Jp-K/smartrope-esp32-v2/LiTE INO 2.2 rev. 01 (GND Plan)/LiTE INO 2.2 rev. 01 (GND Plan).JPG

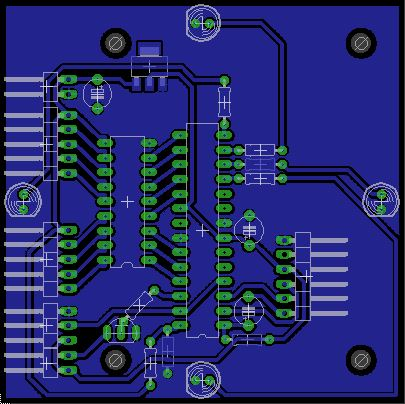
LiTE INO 2.2 rev. 01 (GND Plan)/LiTE INO 2.2 rev. 01 (GND Plan).JPG
