Jp-K/smartrope-esp32-v2/README.md

# A-New-RoPE
Repository for testing the new version of RoPE's firmware
