Jp-K/smartrope-esp32-v2/Firmware/src/Rope/Motors/docs/motor-28BYJ-48-gear-ratio.png

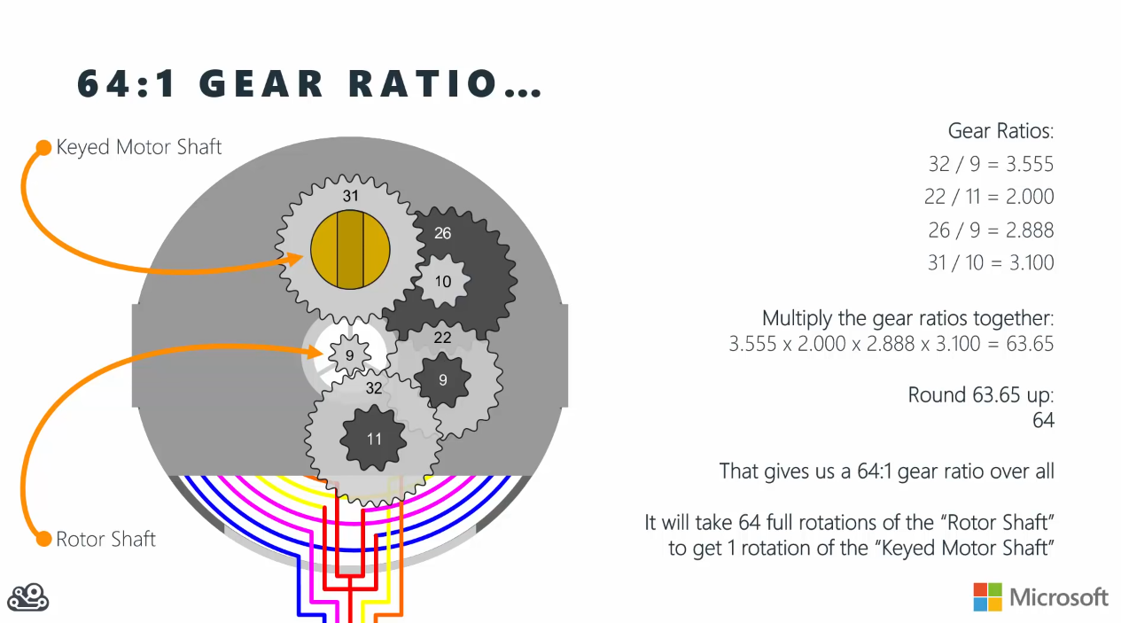
Firmware/src/Rope/Motors/docs/motor-28BYJ-48-gear-ratio.png
