Jp-K/smartrope-esp32-v2/RoPE V3.0 Rev. 00/BOM RoPE V3.0 Rev. 00.xlsx

COMPONENT | QUANTITY | PART NUMBER | PROJECT REFERENCE
Barra de Pinos 1x6x(17mm) 90º | 1 | 68015-406HLF | USB_SERIAL
Barra de Pinos 1x5x(17mm) 90º | 2 | 68015-405HLF | MOTOR_A, MOTOR_B, SPI
Buzzer Passivo | 1 | EET1290-12O-2.4-140-6.5-R-LAB | BUZZER;
Capa para Chave Táctil Amarela | 1 | B32-1330 | KEY_RIGHT;
Capa para Chave Táctil Azul | 1 | B32-1340 | KEY_FRONT;
Capa para Chave Táctil Laranja | 1 | B32-1320 | KEY_BACK;
Capa para Chave Táctil Verde | 1 | B32-1350 | KEY_EXECUTE;
Capa para Chave Táctil Vermelha | 1 | B32-1380 | KEY_LEFT;
Capacitor 100nF 25V/50V | 3 | C1210C104K5RACTU | C3; C4; C5;
Capacitor 10uF 25V/50V | 2 | C1210C106K6PAC7800 | C1; C2;
Capacitor 0,1uF 25V/50V | 3 | C1210C104J1GAC7800 | C7; C10; C11
Chave Táctil 12X12mm | 5 | B3F-4050 | KEY_FRONT; KEY_BACK; KEY_LEFT; KEY_RIGHT; KEY_EXECUTE;
Chip de Carregamento | 1 | TP4056-42-SOP8-PP | CHARGER;
Conector KK 1x6 90º | 1 | PCMN2-06 | SOURCE
Diodo Schottky | 2 | BAT54CLT1G | D1
Driver dos Motores | 1 | ULN2803AFWG | DRIVER;
LED Branco 3V 40 mA | 6 | GW JTLMS1.EM-GVH2-XX55-1-60-R18 | LED_FRONT; LED_BACK; LED_LEFT; LED_RIGHT; LED_EXECUTE; LED_EXECUTE2;
Microcontrolador | 1 | ESP32-WROOM-32D | MPU
Regulador de Tensão 5V | 1 | LM1117MPX-5.0 | VOLTAGE_REG.
Resistor 27kR 5% 1/4W | 1 | CR1206-JW-273ELF | R20
Resistor 100kR 5% 1/4W | 1 | CR1206-JW-104ELF | R20
Resistor 10kR 5% 1/4W | 3 | CR1206-JW-103ELF | R2; R3; R21
Resistor 150R 5% 1/4W | 6 | CR1206-JW-151ELF | R11, R12, R13, R14, R15, R16
Resistor 1k2R 5% 1/4W | 1 | AR1206JR-071K2L | R1;
Resistor 1k5R 5% 1/4W | 1 | AR1206JR-071K5L | R6;
Resistor 1kR 5% 1/4W | 2 | AR1206JR-071KL | R18, R19
Resistor 2k2R 5% 1/4W | 1 | AR1206JR-072K2L | R5;
Resistor 3k3R 5% 1/4W | 1 | AR1206JR-073K3L | R6;
Resistor 470R 5% 1/4W | 1 | AR1206JR-07470RL | R4
Resistor 4k7R 5% 1/4W | 2 | CR1206-JW-472GLF | R7; R10;
Resistor 47kR 5% 1/4W | 1 | CR1206-FX-4702ELF | R9
Resistor 8k2R 5% 1/4W | 1 | CRM1206-FX-8201ELF | R8
Transistor NPN | 3 | 2N2222AUA | T1, T2, T3
