Jp-K/smartrope-esp32-v2/RoPE V3.0 Rev. 00/RQ-0114-04 - INFORMAÄÂES PARA ORÄAMENTO FALCON - MOD.xlsx

Sheet: Dados Cadastrais
 |  |  | INFORMAÇÕES PARA ORÇAMENTO FALCON |  |  |  |  |  |  | RQ-0114 |  | REV.
 |  |  |  |  |  |  |  |  |  | COM |  | 04
 |  |  |  |  |  |  |  |  |  | Folha 1 de 4 |  | 2019-02-25
 |  |  | APLICAÇÃO: Comercial envia ao cliente para preenchimento
1. DADOS CADASTRAIS
RAZÃO SOCIAL: |  |  | A2R2F PRODUTOS E EQUIPAMENTOS DIDATICOS LTDA
NOME FANTASIA: |  |  | CONSTRUCTOYS
CNPJ: | 30.041.507/0001-54 |  |  |  |  | INSCRIÇÃO ESTADUAL: |  |  | 258991429
ENDEREÇO: |  | Rua Julio Kumm |  |  |  |  |  |  |  |  | N°: | 459
CIDADE: |  | Itajaí |  |  |  |  |  |  |  |  | UF: | SC
BAIRRO: |  | Praia Brava |  |  |  |  |  |  | CEP: | 88.306-823
TELEFONE DA EMPRESA: |  |  |  | (47) 9 8403-1153 |  |  |  | PAÍS: |  | Brasil
REGIME TRIBUTÁRIO: |  |  |  | Simples Nacional
RAMO DE ATIVIDADE: |  |  |  | Outros/Qual?
 |  |  |  | Produtos Educacionais
SITE/PÁGINA NA INTERNET: |  |  |  |  | http://www.constructoys.com/
NOME PARA CONTATO: |  |  |  | Paulo Henrique de Souza
TELEFONE DO CONTATO: |  |  |  | (47) 9 8816-7602
DEPARTAMENTO: |  |  |  |  |  |  | CARGO: |  | Projetista
E-MAIL DE CONTATO: |  |  |  | paulo@constructoys.com
2. CONHECEU A FALCON ATRAVÉS DE:
 | INTERNET
 | FEIRAS
x | INDICAÇÃO
 | OUTROS
3. ESTÁ Á PROCURA:
SERVIÇO DE MONTAGEM DE PLACAS ELETRÔNICAS
A Falcon oferece inovações tecnológicas, na otimização de processos industriais e na renovação de produtos, gerando soluções para os nossos clientes.
 | O futuro está em nossas mãos
ARQUIVAMENTO: conforme definido no RQ-0124 Lista Mestra

Sheet: Produto
 |  |  |  | INFORMAÇÕES PARA ORÇAMENTO FALCON |  |  |  |  |  |  |  |  | RQ-0114 |  | REV.
 |  |  |  |  |  |  |  |  |  |  |  |  | COM |  | 04
 |  |  |  |  |  |  |  |  |  |  |  |  | Folha 2 de 4 |  | 2019-02-25
 |  |  |  | APLICAÇÃO: Comercial envia ao cliente para preenchimento
 | 1. INFORMAÇÕES SOBRE O PRODUTO/PROJETO
 | Contato técnico: |  |  | Paulo Henrique de Souza
 | Telefone: |  | (47) 9 8816-7602 |  |  |  |  | Skype: |  | paulo-bc1
 | Nome do Produto: |  |  |  |  |  |  |  |  |  |  |  |  | Classe do Produto*:
 | RoPE |  |  |  |  |  |  |  |  |  |  |  |  | Classe I
 | Descritivo do produto/projeto (escopo) e sua aplicação:
 | A PCI integra a interface de teclado (composta por 5 chaves tácteis) e o controlador de um robô programável educacional. Para maiores informações acesse: https://smartfunbrasil.com/
 | Quantidade de produção: |  |  |  |  | Preço Target (R$): |  |  |  |  | Quem fornece Matéria-Prima:
 | 50 |  |  |  |  |  |  |  |  |  | Falcon
 | Possui arquivos dos Produto? Quais?
 | X | Imagem/Amostra |  |  | X | Gerber |  |  | X | PCB/Qual programa usa? |  |  |  | Eagle
* Em caso de Projeto, preencher somente até a linha pontilhada
 | Produto possui montagem:
 |  | X | PTH |  | X | SMD | TOP/BOTTOM
 | PCI fornecida pelo cliente? |  |  |  | Não |  |  | Forma de fornecimento (PCI):
 | Cliente fornece em painel com quantas peças? |  |  |  |  |  |  |  |  |  | Possui borda?
 | Possui estêncil* para a montagem SMD? (Caso a placa tenha SMD) |  |  |  |  |  |  |  |  |  | Não |  | Qual?
 | PCI possui fiducial*? |  |  |  | Sim |  |  | Se não, tem como inserir no projeto?
 | Deseja receber o produto final em Painel, para melhor armazenagem, controle e qualidade do produto? |  |  |  |  |  |  |  |  |  |  | Não
 | Qual o tipo de solda* usado no produto? |  |  |  |  |  |  | Tin Lead (c/chumbo)
 | Produto possui gravação** de software? |  |  |  |  |  | Sim |  |  | Obs:
 | Se sim, qual o tempo de gravação?
 | Produto possui teste** funcional? |  |  |  |  |  | Sim |  |  |  | Cliente possui giga de teste para fornecer?
 | Se sim, qual o tempo de teste? |  |  |  |  |  |  |  |  |  |  |  | Não
 | Produto possui montagem de agregados mecânicos (caixa plástica, caixa metálica, chicote, etiqueta, outros)? |  |  |  |  |  |  |  |  | Obs: | Capas sobre as chaves tácteis
 |  |  |  |  |  |  |  | Sim
 | O produto possui encapsulamento (verniz, resina, cola quente, silicone, outros)? |  |  |  |  |  |  | Não |  | Obs:
 | Obs: | * Informações adicionais na aba "Ajuda".
 |  | ** Anexar procedimento de gravação e teste se possível para análise.
 | ARQUIVAMENTO: conforme definido no RQ-0124 Lista Mestra

Sheet: Ajuda
 |  | INFORMAÇÕES PARA ORÇAMENTO FALCON | RQ-0114 | REV.
 |  |  | COM | 04
 |  |  | Folha 3 de 4 | 2019-02-25
 |  | APLICAÇÃO: Comercial envia ao cliente para preenchimento
A Falcon oferece inovações tecnológicas, na otimização de processos industriais e na renovação de produtos, gerando soluções para os nossos clientes.
 | O futuro está em nossas mãos
ARQUIVAMENTO: conforme definido no RQ-0124 Lista Mestra
