Jp-K/smartrope-esp32-v2/LiTE INO 2.2 rev. 01 (GND Plan)/LiTE INO 2.2 rev. 01 (GND Plan).pdf

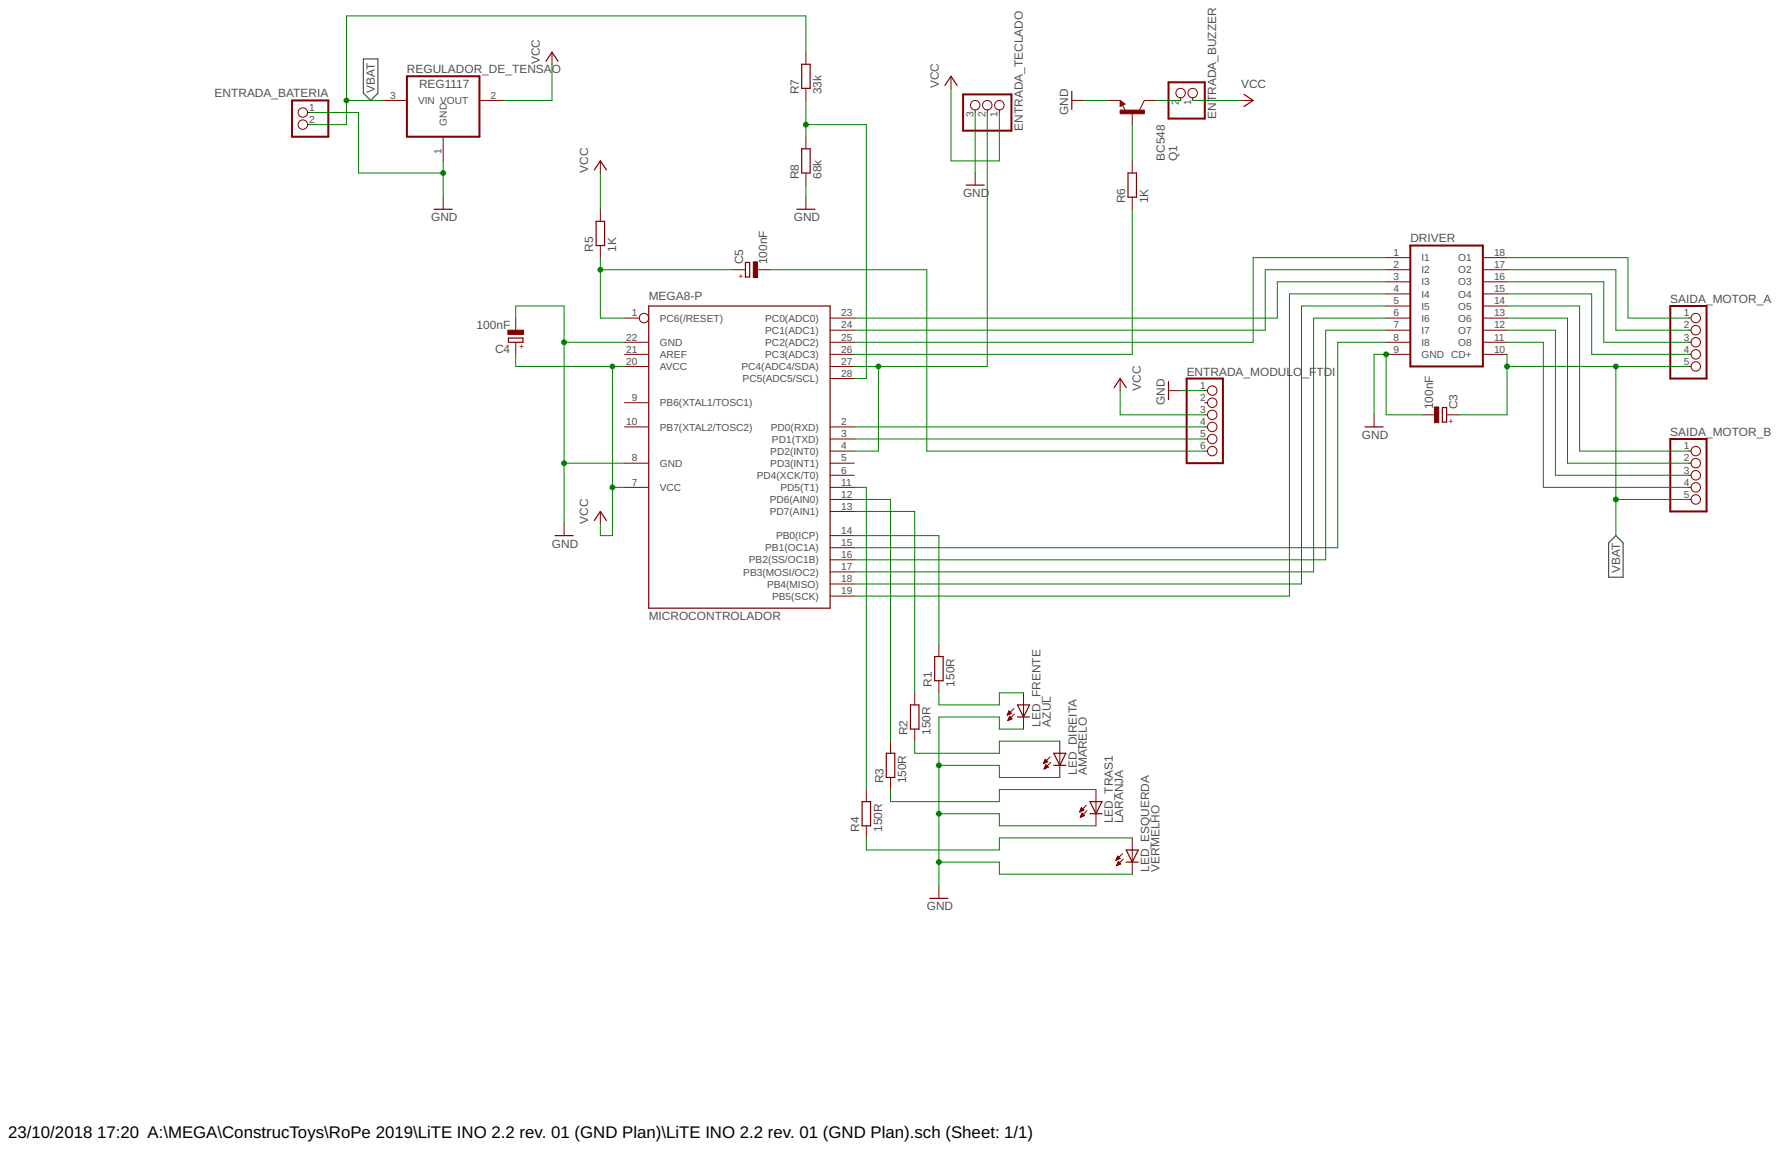
[picture p3: page 1]

23/10/2018 17:20 A:\MEGA\ConstrucToys\RoPe 2019\LiTE INO 2.2 rev. 01 (GND Plan)\LiTE INO 2.2 rev. 01 (GND Plan).sch (Sheet: 1/1)
