Jp-K/smartrope-esp32-v2/LiTE INO 2.2 rev. 01 (GND Plan)/LiTE INO 2.2 rev. 01 (GND Plan).brd

## EAGLE design LiTE INO 2.2 rev. 01 (GND Plan)/LiTE INO 2.2 rev. 01 (GND Plan).brd (2024-12-09)

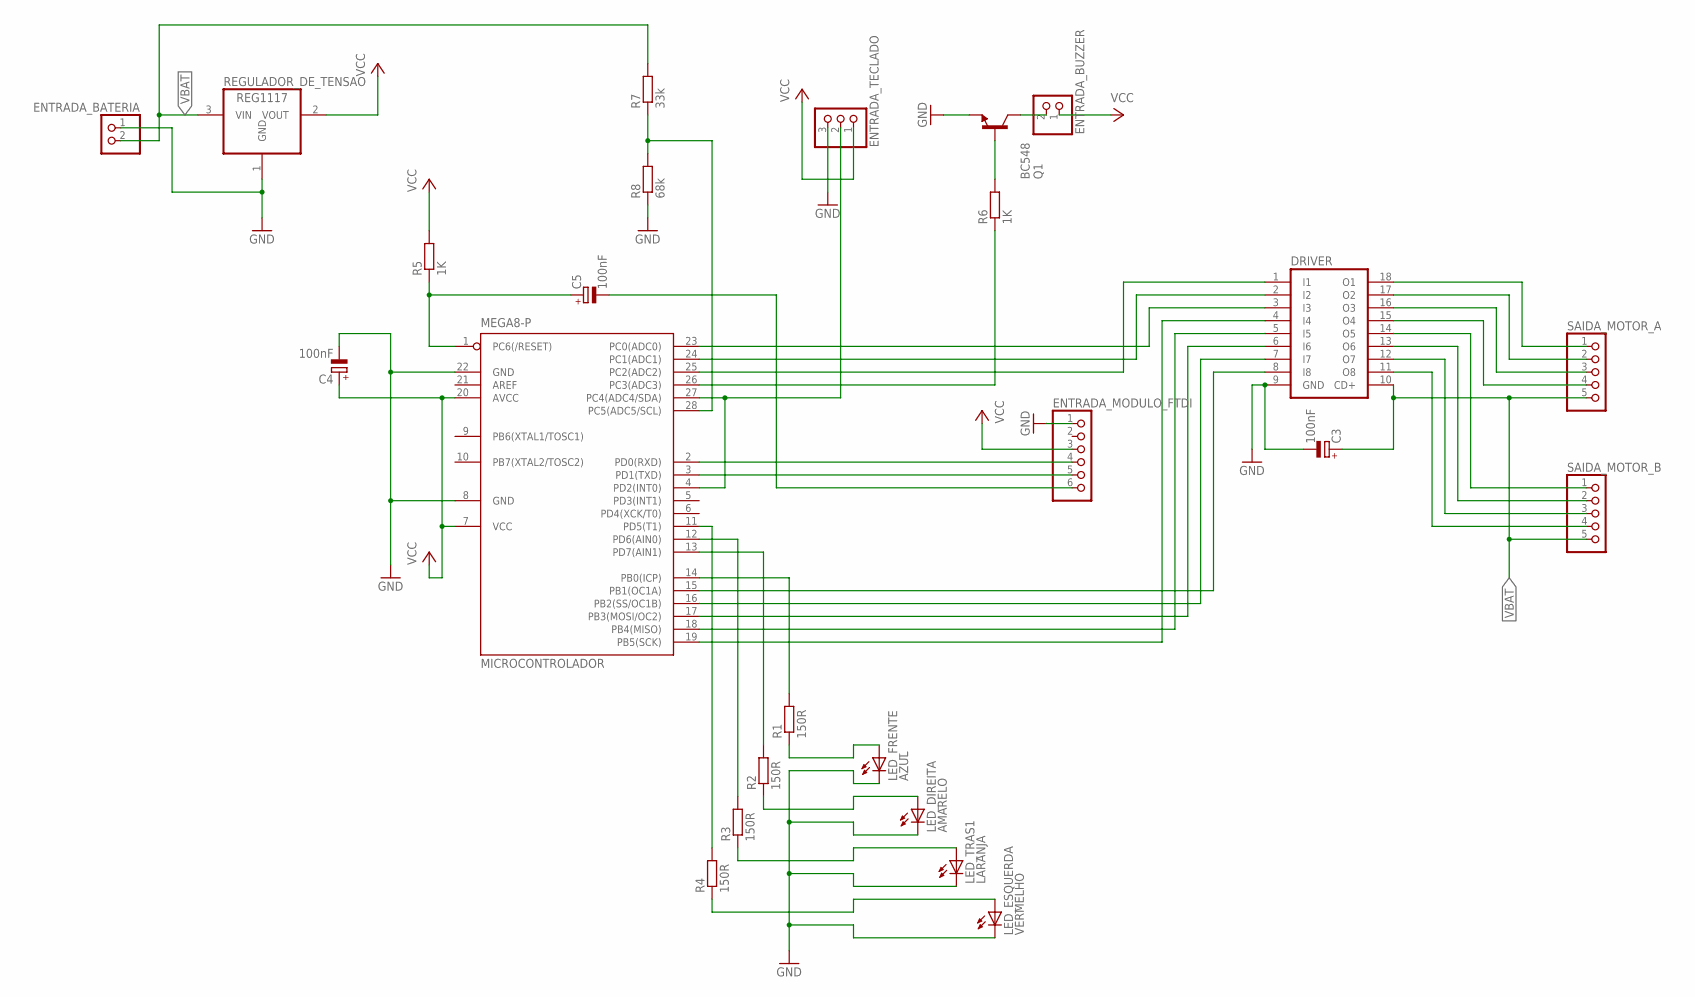
[picture p4: schematic LiTE INO 2.2 rev. 01 (GND Plan).sch]

Parts:
C3, C4, C5: 100nF; E5-5
DRIVER: ULN2803A; DIL18
ENTRADA_BATERIA: PINHD-1X2/90; 1X02/90
ENTRADA_BUZZER: PINHD-1X2/90; 1X02/90
ENTRADA_MODULO_FTDI: PINHD-1X6/90; 1X06/90
ENTRADA_TECLADO: PINHD-1X3/90; 1X03/90
LED_DIREITA: AMARELO; LED5MM
LED_ESQUERDA: VERMELHO; LED5MM
LED_FRENTE: AZUL; LED5MM
LED_TRAS1: LARANJA; LED5MM
MICROCONTROLADOR: MEGA8-P; DIL28-3
Q1: BC548; TO92-EBC
R1, R2, R3, R4: 150R; 0204/7
R5, R6: 1K; 0204/7
R7: 33k; 0204/7
R8: 68k; 0204/7
REGULADOR_DE_TENSAO: REG1117; SOT223
SAIDA_MOTOR_A: PINHD-1X5/90; 1X05/90
SAIDA_MOTOR_B: PINHD-1X5/90; 1X05/90

Connections:
GND: C3.-, C4.-, DRIVER.9 (GND), ENTRADA_BATERIA.1, ENTRADA_MODULO_FTDI.1, ENTRADA_TECLADO.3, LED_DIREITA.K (C), LED_ESQUERDA.K (C), LED_FRENTE.K (C), LED_TRAS1.K (C), MICROCONTROLADOR.8 (GND), MICROCONTROLADOR.22 (GND), Q1.E, R8.1, REGULADOR_DE_TENSAO.1 (GND)
unnamed: DRIVER.1 (I1), MICROCONTROLADOR.25 (PC2(ADC2))
unnamed: DRIVER.2 (I2), MICROCONTROLADOR.24 (PC1(ADC1))
unnamed: DRIVER.3 (I3), MICROCONTROLADOR.23 (PC0(ADC0))
unnamed: DRIVER.4 (I4), MICROCONTROLADOR.19 (PB5(SCK))
unnamed: DRIVER.5 (I5), MICROCONTROLADOR.18 (PB4(MISO))
unnamed: DRIVER.6 (I6), MICROCONTROLADOR.17 (PB3(MOSI/OC2))
unnamed: DRIVER.7 (I7), MICROCONTROLADOR.16 (PB2(SS/OC1B))
unnamed: DRIVER.8 (I8), MICROCONTROLADOR.15 (PB1(OC1A))
unnamed: LED_FRENTE.A, R1.1
unnamed: DRIVER.18 (O1), SAIDA_MOTOR_A.1
unnamed: DRIVER.17 (O2), SAIDA_MOTOR_A.2
unnamed: DRIVER.16 (O3), SAIDA_MOTOR_A.3
unnamed: DRIVER.15 (O4), SAIDA_MOTOR_A.4
unnamed: LED_DIREITA.A, R2.1
unnamed: DRIVER.14 (O5), SAIDA_MOTOR_B.1
unnamed: DRIVER.13 (O6), SAIDA_MOTOR_B.2
unnamed: DRIVER.12 (O7), SAIDA_MOTOR_B.3
unnamed: DRIVER.11 (O8), SAIDA_MOTOR_B.4
unnamed: LED_TRAS1.A, R3.1
unnamed: MICROCONTROLADOR.14 (PB0(ICP)), R1.2
unnamed: MICROCONTROLADOR.13 (PD7(AIN1)), R2.2
unnamed: MICROCONTROLADOR.12 (PD6(AIN0)), R3.2
unnamed: MICROCONTROLADOR.11 (PD5(T1)), R4.2
unnamed: ENTRADA_TECLADO.2, MICROCONTROLADOR.4 (PD2(INT0)), MICROCONTROLADOR.27 (PC4(ADC4/SDA))
unnamed: ENTRADA_BUZZER.2, Q1.C
unnamed: MICROCONTROLADOR.28 (PC5(ADC5/SCL)), R7.1, R8.2
unnamed: LED_ESQUERDA.A, R4.1
unnamed: MICROCONTROLADOR.26 (PC3(ADC3)), R6.1
unnamed: ENTRADA_MODULO_FTDI.4, MICROCONTROLADOR.2 (PD0(RXD))
unnamed: ENTRADA_MODULO_FTDI.5, MICROCONTROLADOR.3 (PD1(TXD))
unnamed: C5.-, ENTRADA_MODULO_FTDI.6
unnamed: C5.+, MICROCONTROLADOR.1 (PC6(/RESET)), R5.1
unnamed: Q1.B, R6.2
VBAT: C3.+, DRIVER.10 (CD+), ENTRADA_BATERIA.2, R7.2, REGULADOR_DE_TENSAO.3 (VIN), SAIDA_MOTOR_A.5, SAIDA_MOTOR_B.5
VCC: C4.+, ENTRADA_BUZZER.1, ENTRADA_MODULO_FTDI.3, ENTRADA_TECLADO.1, MICROCONTROLADOR.7 (VCC), MICROCONTROLADOR.20 (AVCC), R5.2, REGULADOR_DE_TENSAO.2 (VOUT)

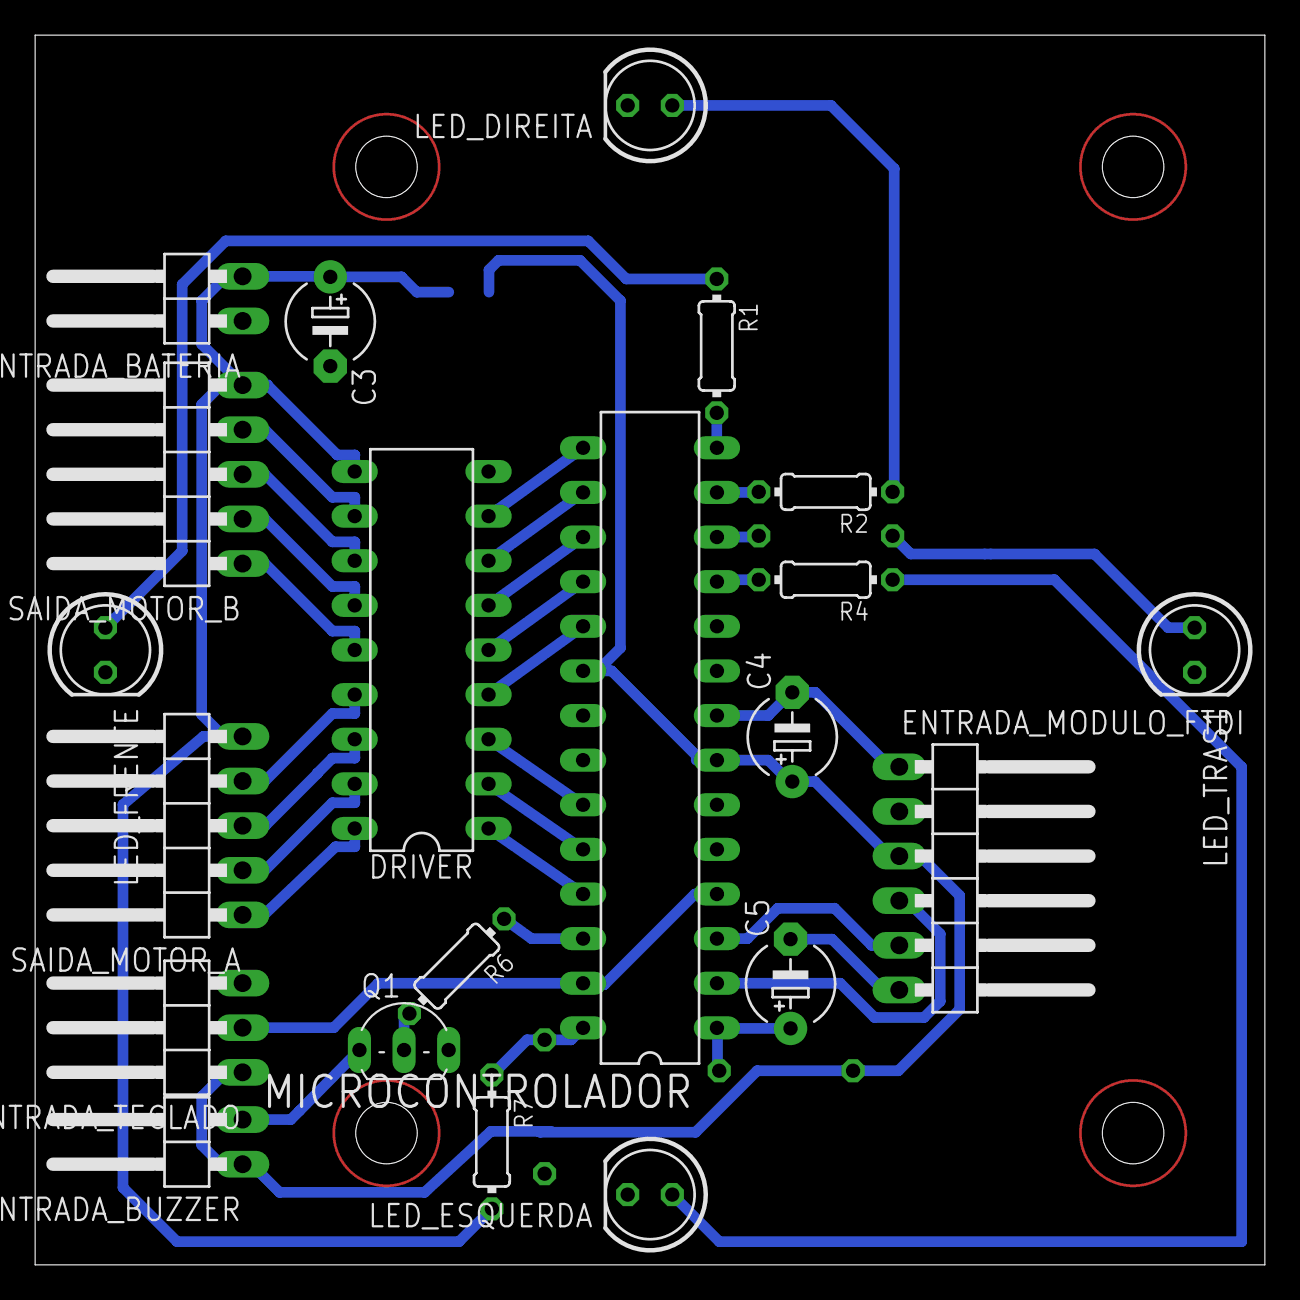
[picture p5: board LiTE INO 2.2 rev. 01 (GND Plan).brd from above]

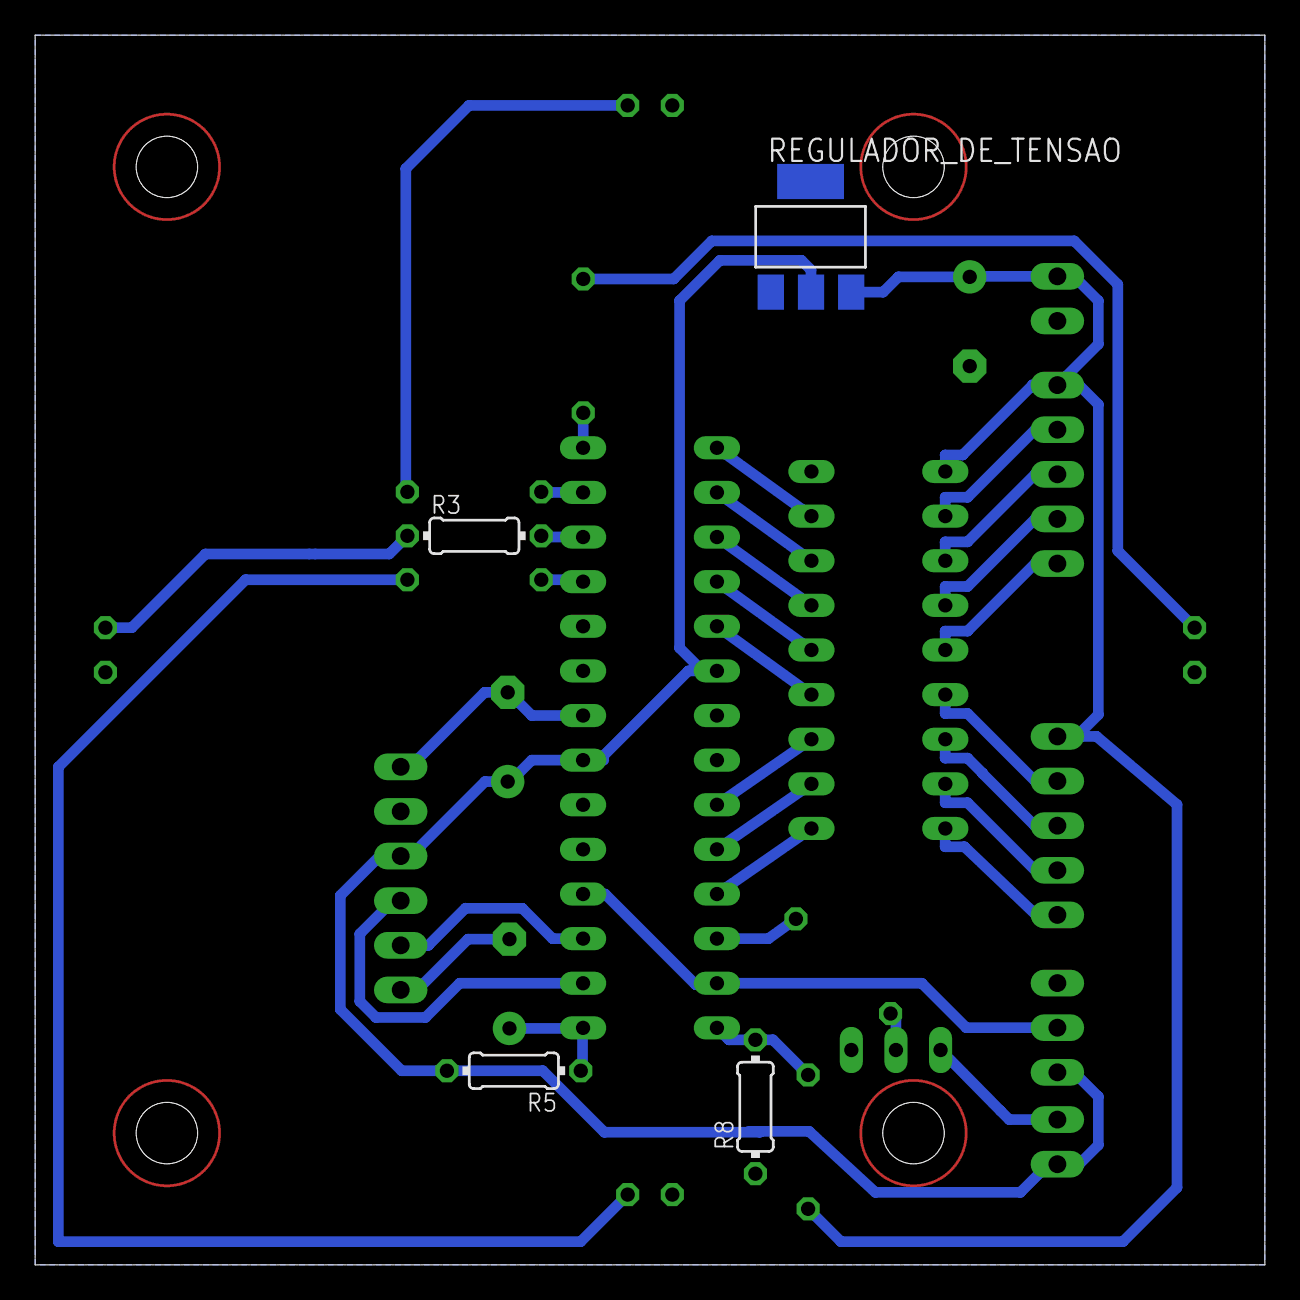
[picture p6: board LiTE INO 2.2 rev. 01 (GND Plan).brd from below]

Board: 2 copper layers, 70.0 x 70.0 mm, 25 parts (4 on the bottom side), 36 nets.
