Jp-K/smartrope-esp32-v2/RoPE V3.0 Rev. 00/RoPE V3.0 Rev. 00.brd

## EAGLE design RoPE V3.0 Rev. 00/RoPE V3.0 Rev. 00.brd (2024-12-09)

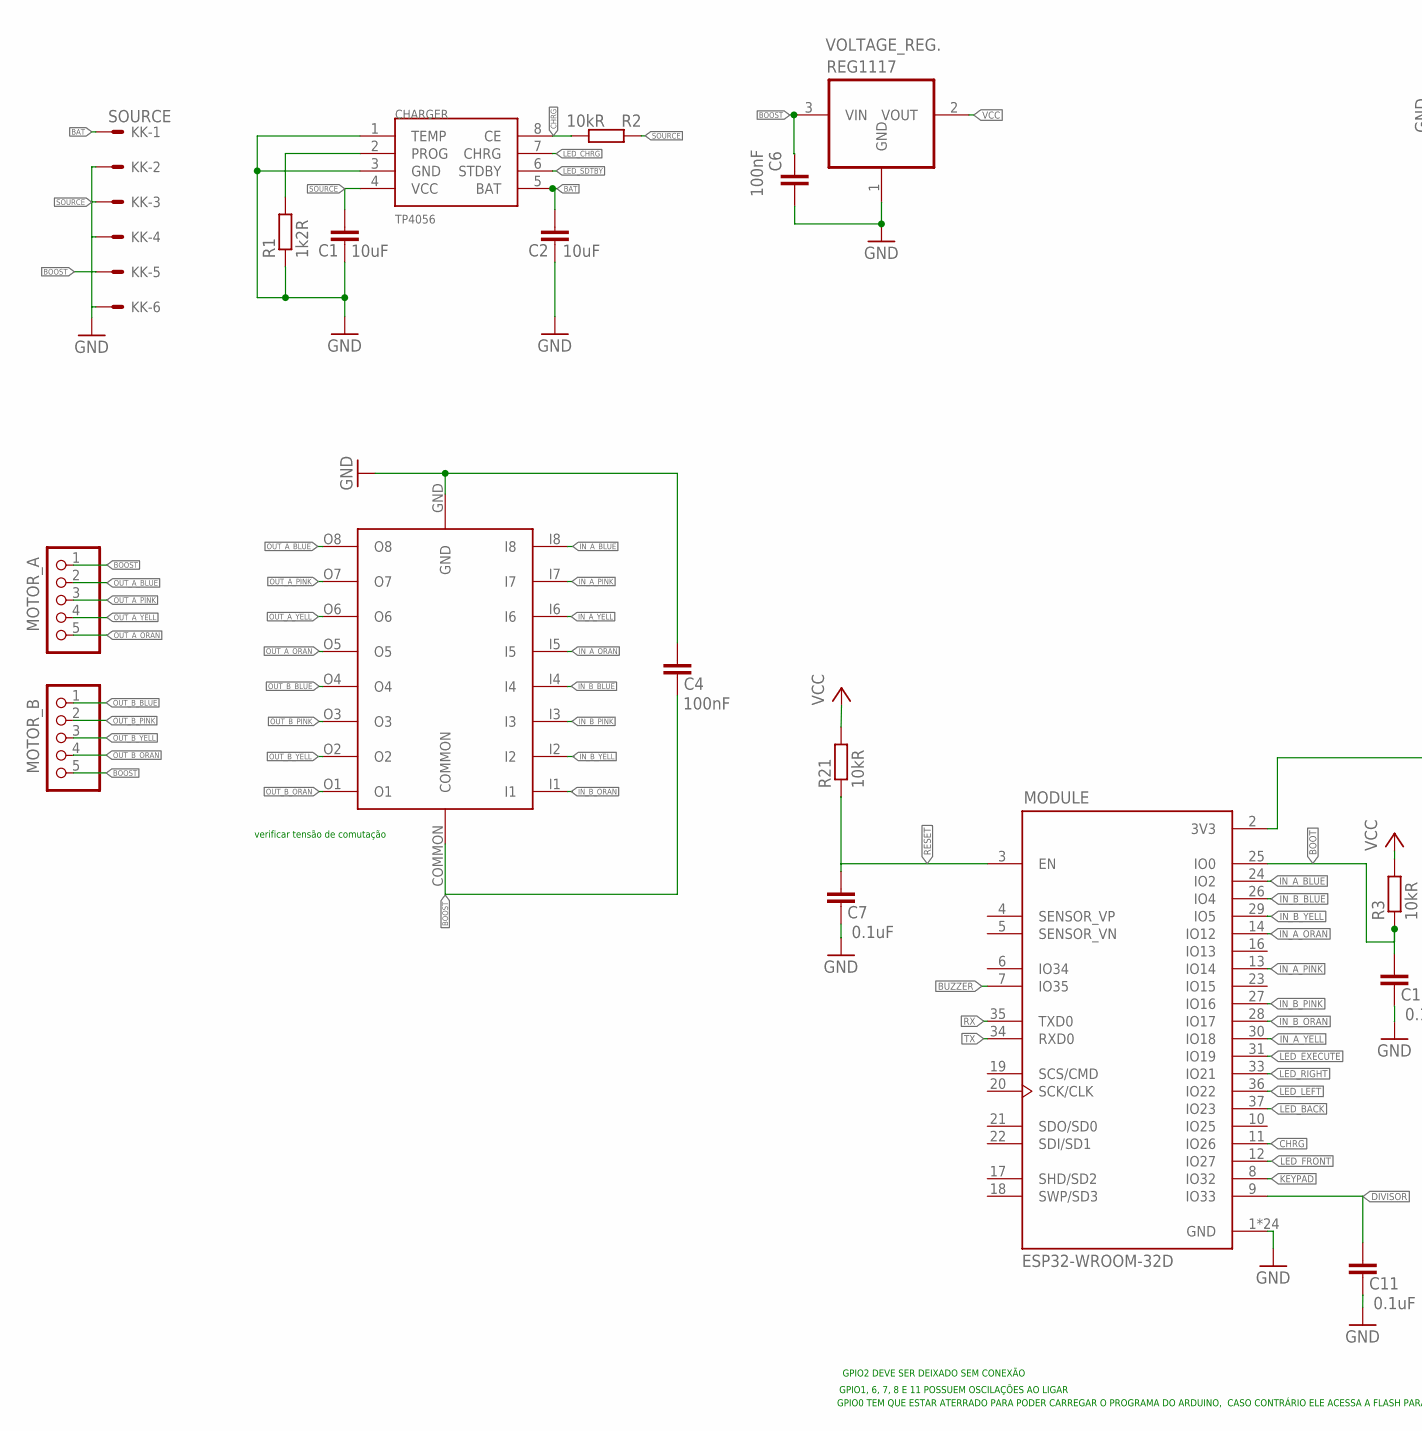
[picture p7: schematic RoPE V3.0 Rev. 00.sch, part in row 1, column 1]

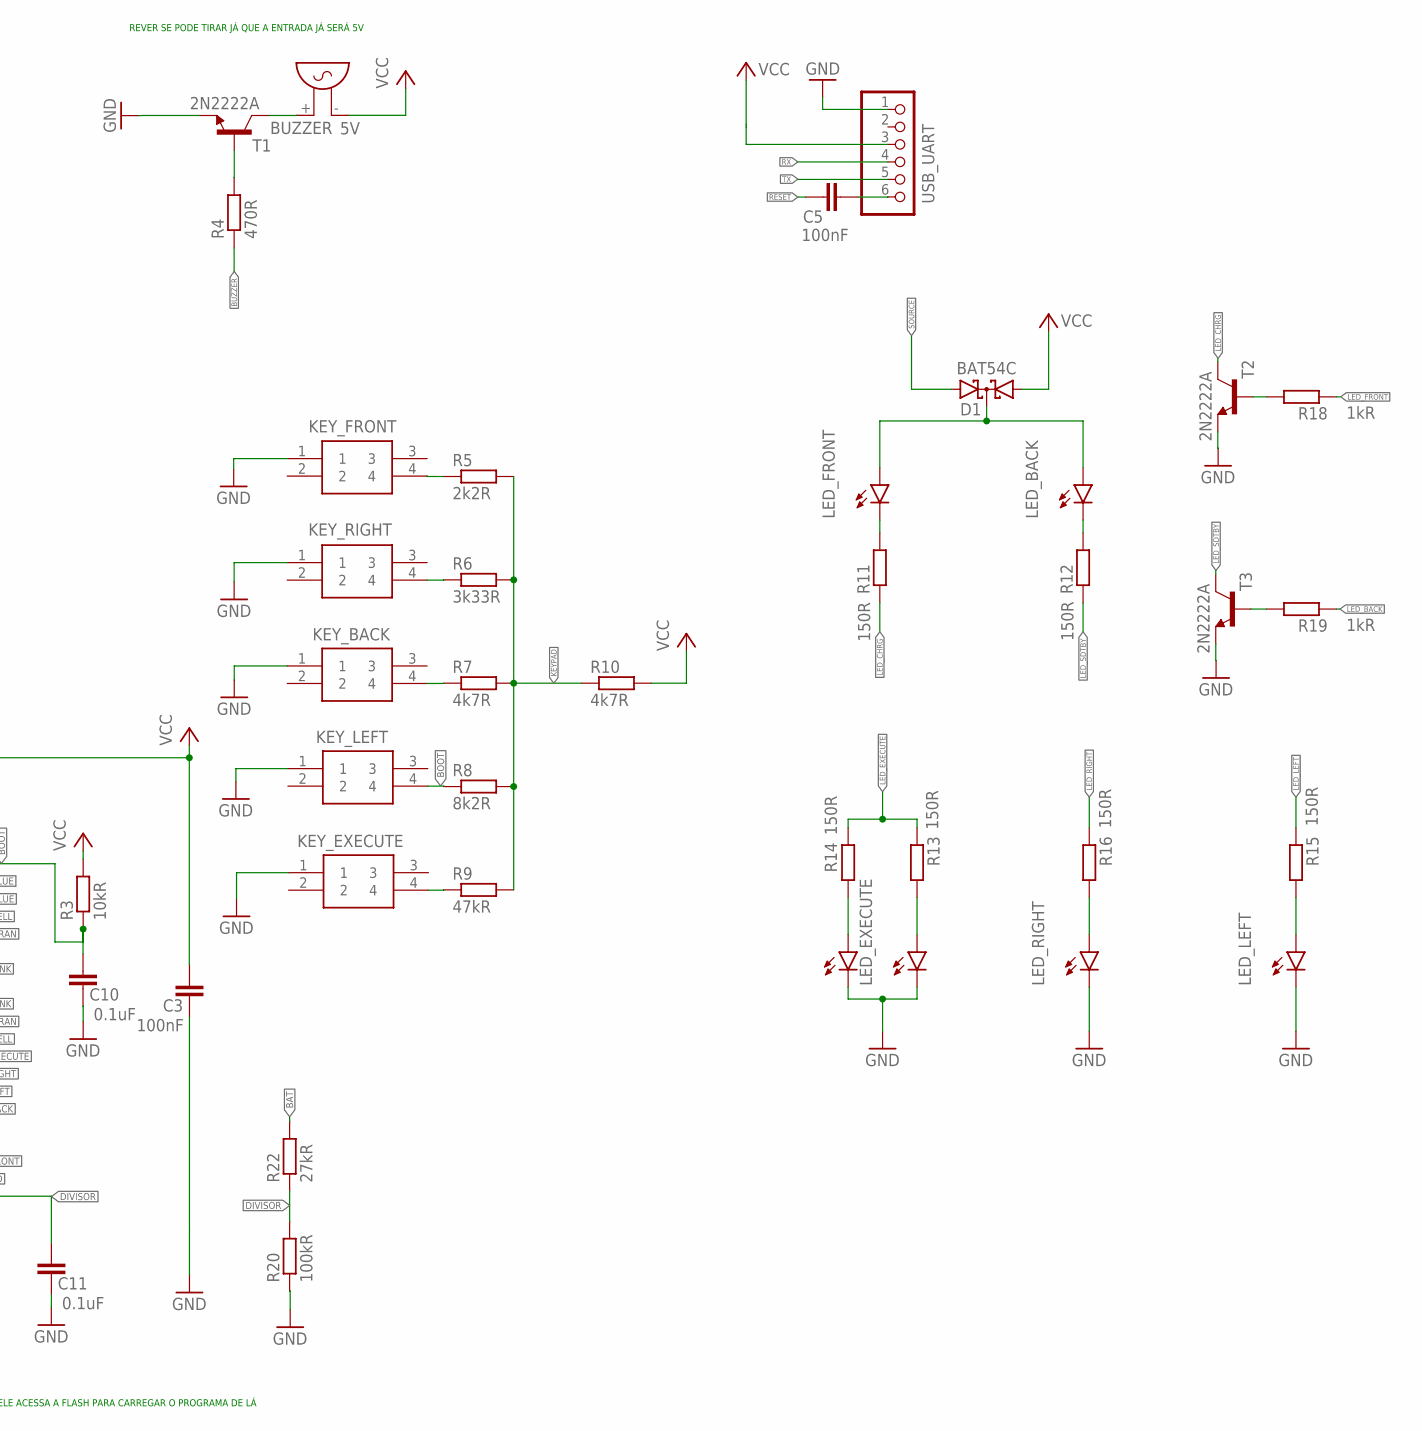
[picture p8: schematic RoPE V3.0 Rev. 00.sch, part in row 1, column 2]

Parts:
BUZZER: 5V; F/QMX
C1, C2: 10uF; C1210
C3, C4, C5, C6: 100nF; C1210
C7, C10, C11: 0.1uF; C1210
CHARGER: TP4056; SOP-8
D1: BAT54C; SOT23
DRIVER: ULN2803AFWG
KEY_BACK: B3F-4050; B3F-4000
KEY_EXECUTE: B3F-4050; B3F-4000
KEY_FRONT: B3F-4050; B3F-4000
KEY_LEFT: B3F-4050; B3F-4000
KEY_RIGHT: B3F-4050; B3F-4000
KK: SOURCE; 7395-06
LED_BACK: ORANGE; KA-3528ASYC
LED_EXECUTE, LED_EXECUTE2: GREEN; KA-3528ASYC
LED_FRONT: BLUE; KA-3528ASYC
LED_LEFT: RED; KA-3528ASYC
LED_RIGHT: RED; KA-3528ASYC
MODULE: ESP32-WROOM-32D; MODULE_ESP32-WROOM-32D
MOTOR_A: PINHD-1X5/90; 1X05/90
MOTOR_B: PINHD-1X5/90; 1X05/90
R1: 1k2R; R1206W
R2, R3, R21: 10kR; R1206W
R4: 470R; R1206W
R5: 2k2R; R1206W
R6: 3k33R; R1206W
R7, R10: 4k7R; R1206W
R8: 8k2R; R1206W
R9: 47kR; R1206W
R11, R12, R13, R14, R15, R16: 150R; R1206W
R18, R19: 1kR; R1206W
R20: 100kR; R1206W
R22: 27kR; R1206W
T1, T2, T3: 2N2222A; SOT23-BEC
USB_UART: PINHD-1X6/90; 1X06/90
VOLTAGE_REG.: REG1117; SOT223

Connections:
BAT: C2.2, CHARGER.5 (BAT), KK.1, R22.2
BOOST: C4.1, C6.2, DRIVER.COMMON, KK.5, MOTOR_A.1, MOTOR_B.5, VOLTAGE_REG..3 (VIN)
BOOT: C10.2, KEY_LEFT.4, MODULE.25 (IO0), R3.1, R8.1
BUZZER: MODULE.7 (IO35), R4.1
CHRG: CHARGER.8 (CE), MODULE.11 (IO26), R2.2
DIVISOR: C11.2, MODULE.9 (IO33), R20.2, R22.1
GND: C1.1, C2.1, C3.1, C4.2, C6.1, C7.1, C10.1, C11.1, CHARGER.1 (TEMP), CHARGER.3 (GND), DRIVER.GND, KEY_BACK.1, KEY_EXECUTE.1, KEY_FRONT.1, KEY_LEFT.1, KEY_RIGHT.1, KK.2, KK.4, KK.6, LED_EXECUTE.C, LED_EXECUTE2.C, LED_LEFT.C, LED_RIGHT.C, MODULE.1 (GND), MODULE.15 (GND), MODULE.38 (GND), MODULE.39_1 (GND), MODULE.39_2 (GND), MODULE.39_3 (GND), MODULE.39_4 (GND), MODULE.39_5 (GND), MODULE.39_6 (GND), MODULE.39_7 (GND), MODULE.39_8 (GND), MODULE.39_9 (GND), MODULE.39_10 (GND), MODULE.39_11 (GND), MODULE.39_12 (GND), MODULE.39_13 (GND), MODULE.39_14 (GND), MODULE.39_15 (GND), MODULE.39_16 (GND), MODULE.39_17 (GND), MODULE.39_18 (GND), MODULE.39_19 (GND), MODULE.39_20 (GND), MODULE.39_21 (GND), R1.1, R20.1, T1.E, T2.E, T3.E, USB_UART.1, VOLTAGE_REG..1 (GND)
IN_A_BLUE: DRIVER.I8, MODULE.24 (IO2)
IN_A_ORAN: DRIVER.I5, MODULE.14 (IO12)
IN_A_PINK: DRIVER.I7, MODULE.13 (IO14)
IN_A_YELL: DRIVER.I6, MODULE.30 (IO18)
IN_B_BLUE: DRIVER.I4, MODULE.26 (IO4)
IN_B_ORAN: DRIVER.I1, MODULE.28 (IO17)
IN_B_PINK: DRIVER.I3, MODULE.27 (IO16)
IN_B_YELL: DRIVER.I2, MODULE.29 (IO5)
KEYPAD: MODULE.8 (IO32), R5.2, R6.2, R7.2, R8.2, R9.2, R10.1
LED_BACK: MODULE.37 (IO23), R19.1
LED_CHRG: CHARGER.7 (CHRG), R11.1, T2.C
LED_EXECUTE: MODULE.31 (IO19), R13.1, R14.1
LED_FRONT: MODULE.12 (IO27), R18.1
LED_LEFT: MODULE.36 (IO22), R15.1
LED_RIGHT: MODULE.33 (IO21), R16.1
LED_SDTBY: CHARGER.6 (STDBY), R12.1, T3.C
unnamed: C5.1, USB_UART.6
unnamed: KEY_RIGHT.4, R6.1
unnamed: LED_BACK.C, R12.2
unnamed: KEY_FRONT.4, R5.1
unnamed: BUZZER.+ (2), T1.C
unnamed: R4.2, T1.B
unnamed: LED_FRONT.C, R11.2
unnamed: LED_EXECUTE.A, R13.2
unnamed: LED_EXECUTE2.A, R14.2
unnamed: LED_RIGHT.A, R16.2
unnamed: LED_LEFT.A, R15.2
unnamed: CHARGER.2 (PROG), R1.2
unnamed: KEY_BACK.4, R7.1
unnamed: R19.2, T3.B
unnamed: R18.2, T2.B
unnamed: D1.3 (CC), LED_BACK.A, LED_FRONT.A
unnamed: KEY_EXECUTE.4, R9.1
OUT_A_BLUE: DRIVER.O8, MOTOR_A.2
OUT_A_ORAN: DRIVER.O5, MOTOR_A.5
OUT_A_PINK: DRIVER.O7, MOTOR_A.3
OUT_A_YELL: DRIVER.O6, MOTOR_A.4
OUT_B_BLUE: DRIVER.O4, MOTOR_B.1
OUT_B_ORAN: DRIVER.O1, MOTOR_B.4
OUT_B_PINK: DRIVER.O3, MOTOR_B.2
OUT_B_YELL: DRIVER.O2, MOTOR_B.3
RESET: C5.2, C7.2, MODULE.3 (EN), R21.1
RX: MODULE.35 (TXD0), USB_UART.4
SOURCE: C1.2, CHARGER.4 (VCC), D1.2 (A2), KK.3, R2.1
TX: MODULE.34 (RXD0), USB_UART.5
VCC: BUZZER.- (1), C3.2, D1.1 (A1), MODULE.2 (3V3), R3.2, R10.2, R21.2, USB_UART.3, VOLTAGE_REG..2 (VOUT)

Notes on the sheet:
GPIO0 TEM QUE ESTAR ATERRADO PARA PODER CARREGAR O PROGRAMA DO ARDUINO, CASO CONTRÁRIO ELE ACESSA A FLASH PARA CARREGAR O PROGRAMA DE LÁ
GPIO2 DEVE SER DEIXADO SEM CONEXÃO
GPIO1, 6, 7, 8 E 11 POSSUEM OSCILAÇÕES AO LIGAR
REVER SE PODE TIRAR JÁ QUE A ENTRADA JÁ SERÁ 5V
verificar tensão de comutação

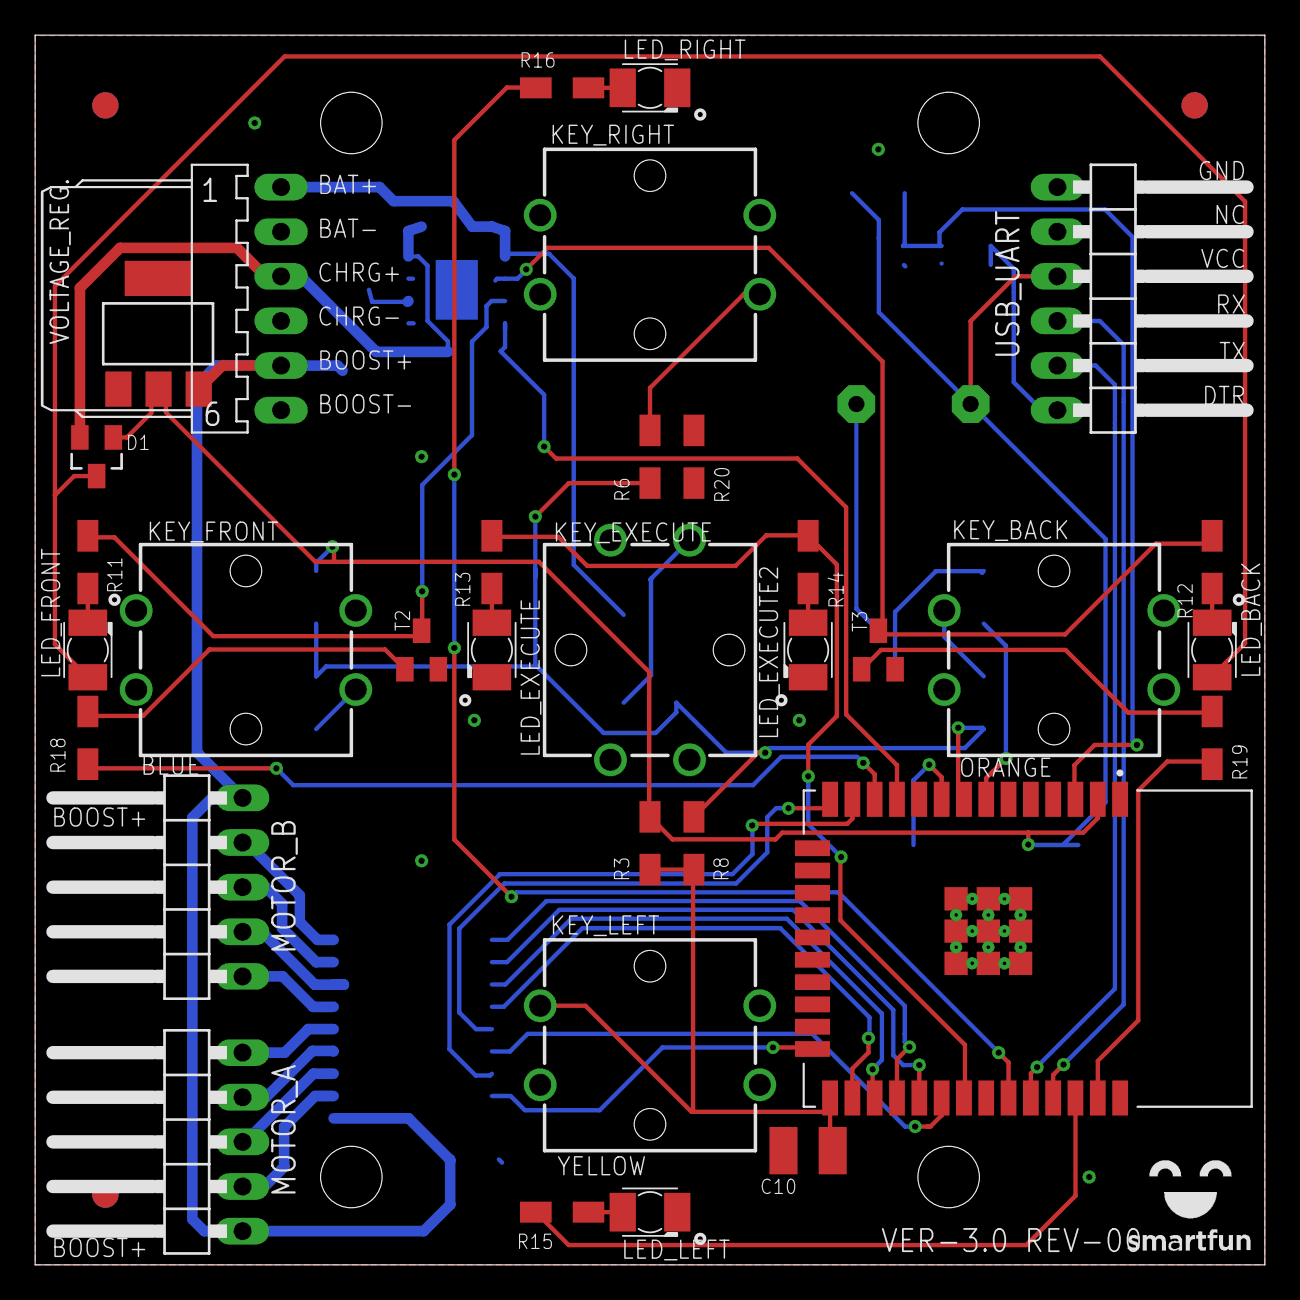
[picture p9: board RoPE V3.0 Rev. 00.brd from above]

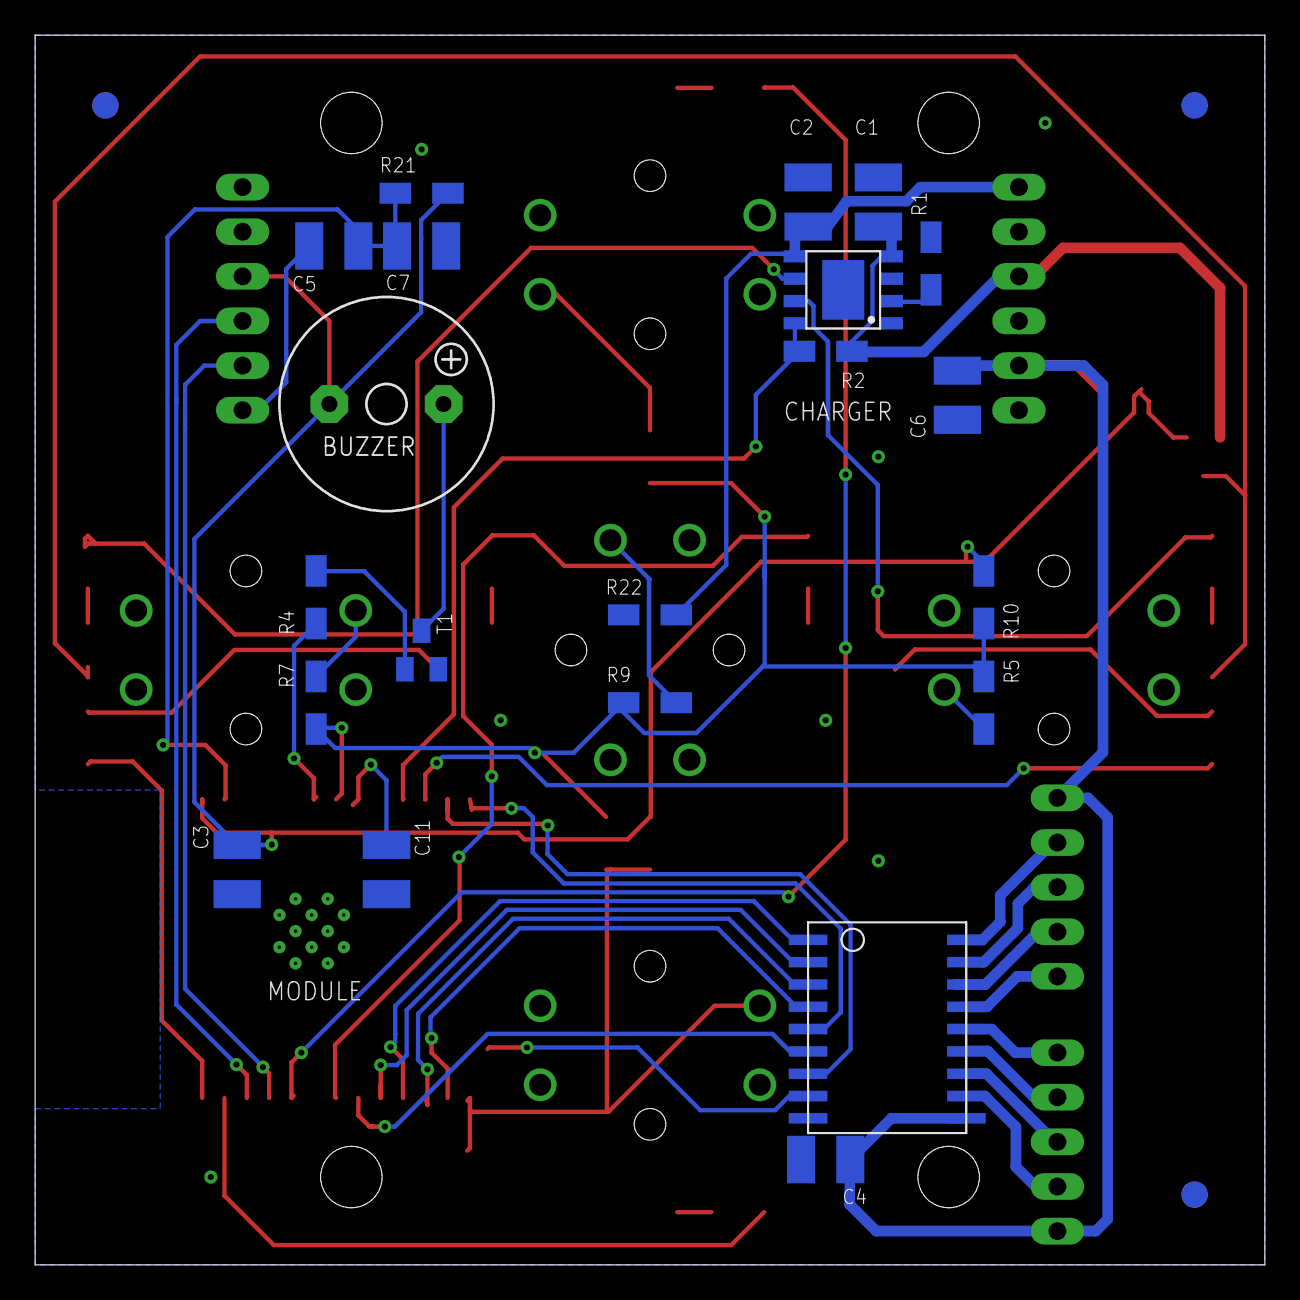
[picture p10: board RoPE V3.0 Rev. 00.brd from below]

Board: 2 copper layers, 70.0 x 70.0 mm, 60 parts (24 on the bottom side), 53 nets.

Other parts of the board:
U$1, U$2, U$3, U$4, U$5, U$6: FIDUCIAL_G15
