Jp-K/smartrope-esp32-v2/Firmware/src/Rope/IoT/Commands/RemoveInstructionCommand.hpp

#ifndef ROPE_IOT_REMOVE_INSTRUCTION_COMMAND_HPP
#define ROPE_IOT_REMOVE_INSTRUCTION_COMMAND_HPP

#include "Rope/IoT/Command.hpp"

namespace Rope
{
    class RemoveInstructionCommand : public Command
    {
    public:
        RemoveInstructionCommand(RopeToy& rope);

        bool execute(const std::string& requester, const JsonObject& parameters) const;
    };
}

#endif // ROPE_IOT_REMOVE_INSTRUCTION_COMMAND_HPP
