Jp-K/smartrope-esp32-v2/Firmware/include/dependencies.h

// Includes for project libraries and headers

#include <debug.h>
#include <pinout.h>
#include <config.h>
#include <buzzer.hpp>
#include <keypad.hpp>
// #include <program.hpp>
#include <cpu.hpp>
#include <battery.hpp>
#include <motor_controller.hpp>
#include <trapezoidal_curve.hpp>
#include <timer.hpp>

#include "UnitParams.h"
#include "WiFiParams.h"

// Includes for atmel/compiler libraries and headers

#include <Arduino.h>

#include <Arduino.h>
#include <WiFi.h>
// #include <ArduinoJson.h>
#include <Ticker.h>
#include <math.h>
